siliconvalley4066/ESP32OLEDOscilloscope/README.md

# ESP32OLEDOscilloscope
ESP32 Oscilloscope for OLED and wireless WEB display

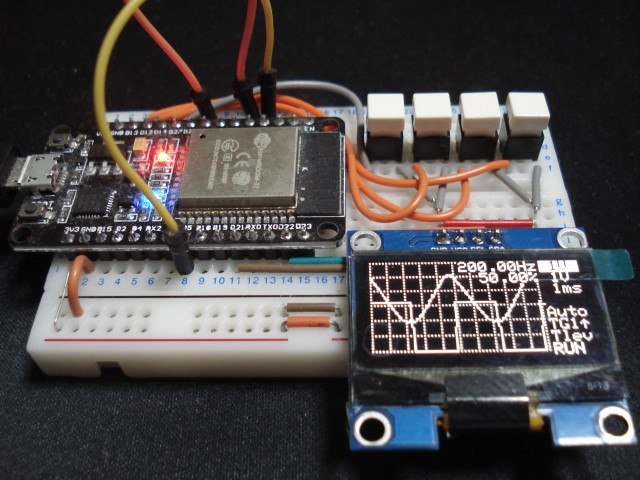
[picture p1: DSC00021.jpg]

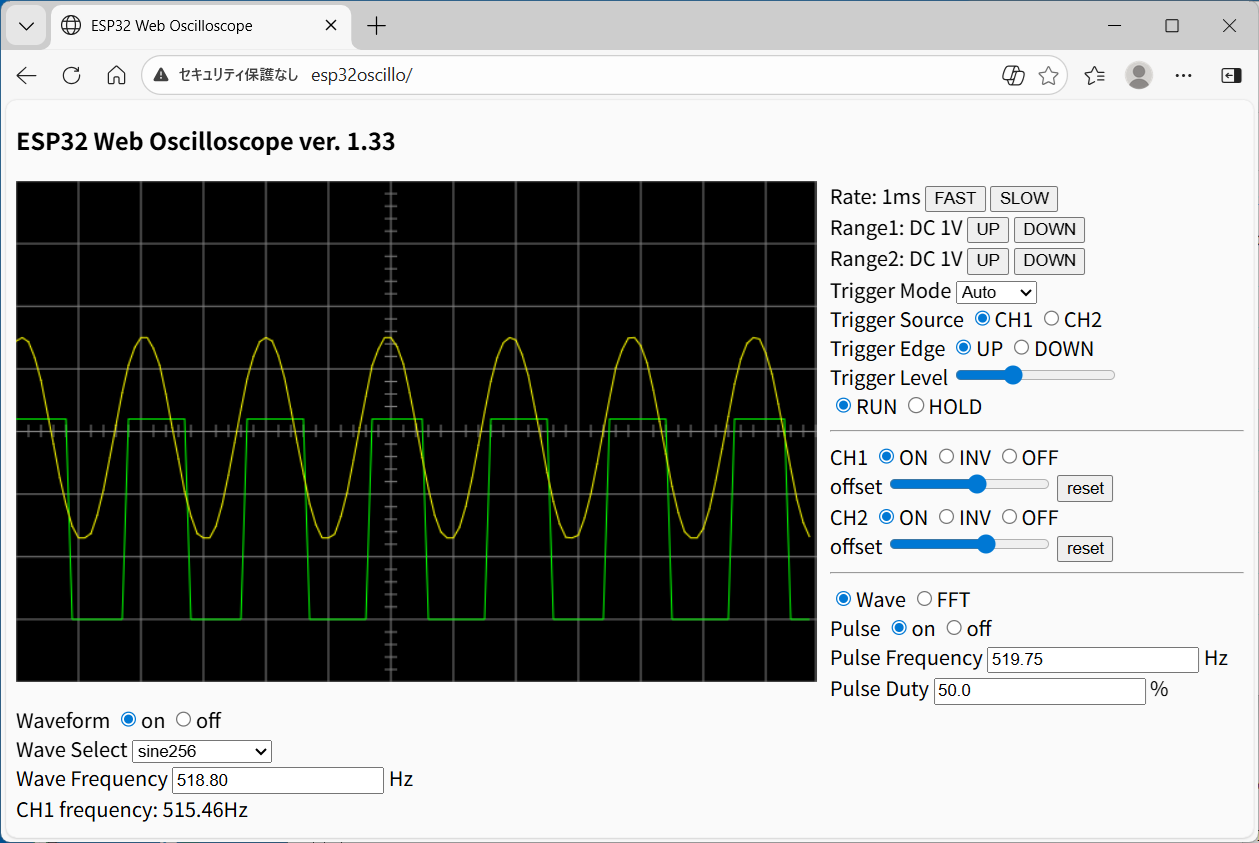
[picture p2: ESP32WEBOLED.png]


This displays an oscilloscope screen both on a 128x64 OLED and also on the WEB page simultaneusly.
The settings are controled by four tactile switches and also on the WEB page.
You can view the oscilloscope screen on the WEB browser of the PC or the tablet or the smartphone.

Specifications:
- Dual input channel
- Input voltage range 0 to 3.3V
- 12 bit ADC 250 ksps single channel, 100 ksps dual channel<br>
On ESP32-C3 Super Mini, 83.333 ksps single channel, 40 ksps dual channel
- Measures minimum, maximum and average values
- Measures frequency and duty cycle
- Spectrum FFT analysis
- Sampling rate selection
- Built in Pulse Generator
- Built in DDS Function Generator
- Built in Frequency Counter 1Hz - 32MHz (Max 40MHz)

<p>
Develop environment is:<br>
Arduino IDE 2.3.10<br>
esp32 by Espressif Systems version 3.3.12<br>
CPU speed 240 MHz<br>
  
Select the board for ESP32-C3 Super Mini: "Nologo ESP32C3 Super Mini"<br>
USB CDC On Boot: "Enabled"
</p>

Libraries:<br>
Adafruit_SSD1306<br>
Adafruit_SH110X<br>
arduinoFFT by Enrique Condes 2.0.0<br>
WebSockets by Markus Sattler version 2.7.2<br>
WiFiManager by tzapu 2.0.17<br>

4usec/div range is 10 times magnification at 250ksps.<br>
8usec/div range is 5 times magnification at 250ksps.<br>
20usec/div range is 2 times magnification at 250ksps.<br>
The magnification applies sin(x)/x interpolation.

WiFi Manager is used for web-based configuration.
For the initial setup only, connect to the access point named "ESP32_XXXXXXXX" (where "XXXXXXXX" is a unique chip ID) and navigate to "192.168.4.1".
From there, enter the SSID and password for your target WiFi network.
Once configured, no further setup is required.
If you wish to change these settings, hold down the "DOWN" button while the device is starting up.

Schematics:<br>
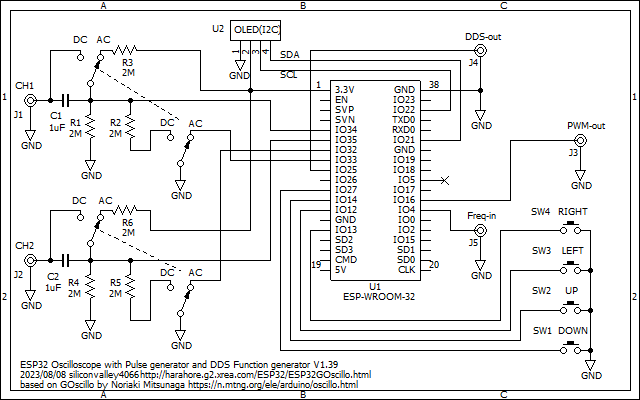
[picture p3: ESP32GOscillo2.png]


Schematics for ESP32-C3 Super Mini:<br>
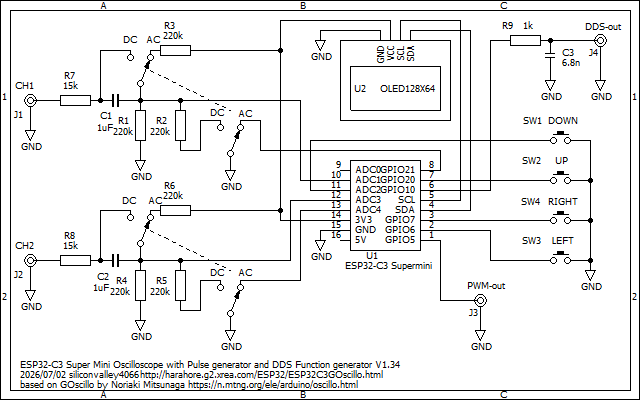
[picture p4: ESP32C3GOscillo.png]


Description is here, although it is written in Japanese language:<br>
https://ss1.xrea.com/harahore.g2.xrea.com/ESP32/ESP32WebOscillo.html
