siliconvalley4066/ESP32OLEDOscilloscope/(threads)

Thread 1 (2025-02-19):

Problem with Arduino ESP32 Nano board

rprior04938, 2025-02-19:
I'm trying to create your wonderful OLED Web multifunction oscilloscope using the Arduino IDE and an Arduino ESP32 nano board bought from Amazon which uses the ESP32S3 chip.  I followed your ReadMe instructions, loaded the necessary libraries, and have loaded the Arduino ESP32 Board manager Version 2.0.11 and the esp32 Version 2.0.11 manager.  The project won't compile.  In particular, the DAC functions seem to be missing.  I have found that the ESP idf  versions 4.x do contain them, and have read that the Arduino ESP32 Board manager version 2.0.11 roughly uses the ESP idf version 4.x libraries.  Do you have any thoughts about how to include those libraries in the Arduino ide?  Many thanks.  Rod

rprior04938, 2025-02-20:
I'v;e answered my own question.  The esp32 S3 doesn't contain any DAC's!.  Yellobyte has created an Arduino library DacESP32 to get around the problem, but it looks like the Oscilloscope sketch will need to be edited in order to use the Library.  Rod

Closed 2025-02-20.

Thread 2 (2025-03-09):

Compile Time Error, "timerAlarmEnable' was not declared in this scope"

ForrestErickson, 2025-03-09:
# Summary
Compile time error.

```
exit status 1

Compilation error: 'timerAlarmEnable' was not declared in this scope; did you mean 'timerAlarm'?
```

## Setup to reproduce
I forked the project.
I cloned the for locally.
I opened in Arduino IED 2.3.3 (See screen shot below)
I set device for for **ESP32 Dev Module**
I added the required libraries(s)
I compiled and got error(s)

**Screen shot:**
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

### Sample of Compiler Record With First Error

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

ForrestErickson, 2025-03-09:
# Same problem IDE 1.8.19
I tried the older IDE and reproduced the problem
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

ForrestErickson, 2025-03-09:
# Comment out timerAlarmEnable, Found Error on call of timerBegin
I commented out the two instances of call to timerAlarmEnable.
Found additional compile error.

```
exit status 1
too many arguments to function 'hw_timer_t* timerBegin(uint32_t)'

```

## Some Details of Error
DDS_DAC:118:23: error: too many arguments to function 'void timerAttachInterrupt(hw_timer_t*, void (*)())'
  118 |   timerAttachInterrupt(timer, &onTimer, true);
      |   ~~~~~~~~~~~~~~~~~~~~^~~~~~~~~~~~~~~~~~~~~~~

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

siliconvalley4066, 2025-04-20:
Use esp32 by Espressif Systems version 2.0.17
Version 3.0 and later does NOT support backward compatibility.

ForrestErickson, 2025-04-21:
Thanks for explaining.
I am not sure what "Use esp32 by Espressif Systems version 2.0.17" means.  Is this an Arduino IDE Library?

siliconvalley4066, 2025-04-22:
It is NOT an Arduino IDE Library.  It is a board support package.  You are using version 3.0.7.  You can version down it with Board Manager.
There are some problems with fast A/D conversion in version 3.0.7 that I can't fix.
