siliconvalley4066/ESP32OLEDOscilloscope/GOscillo/GOscillo.ino

/*
 * ESP32 Oscilloscope using a 128x64 OLED Version 1.43
 * for esp32 by Espressif Systems version 3.3.11
 * The max software loop sampling rates are 5ksps with 2 channels.
 * In the Continuous DMA mode, it can be set up to 100ksps with 2 channels and 250ksps with single channel.
 * + Pulse Generator
 * + PWM DDS Function Generator (23 waveforms)
 * + Frequency Counter
 * Copyright (c) 2023,2026, Siliconvalley4066
 */
/*
 * Arduino Oscilloscope using a graphic LCD
 * The max sampling rates are 4.3ksps with 2 channels and 8.6ksps with a channel.
 * Copyright (c) 2009, Noriaki Mitsunaga
 */

#include "driver/adc.h"
//#include "esp_task_wdt.h"

#if defined(ARDUINO_NOLOGO_ESP32C3_SUPER_MINI) || defined(ARDUINO_ESP32C3_DEV) || defined(ARDUINO_WAVESHARE_ESP32_C3_ZERO)
#define ESP32_C3
#endif
#ifndef ESP32_C3
#include "FreqCountESPgate.h"
#endif
//#define NOWEB
//#define BUTTON5DIR
#define DISPLAY_IS_SSD1306
//#define DISPLAY_IS_SH1107V
#define SCREEN_WIDTH   128              // OLED display width
#define SCREEN_HEIGHT   64              // OLED display height
#define OLED_RESET      -1      // Reset pin # (or -1 if sharing Arduino reset pin)
#ifdef DISPLAY_IS_SSD1306
#include <Adafruit_SSD1306.h>
Adafruit_SSD1306 display(SCREEN_WIDTH, SCREEN_HEIGHT, &Wire, OLED_RESET);
#else
#include <Adafruit_SH110X.h>
#ifdef DISPLAY_IS_SH1107V
Adafruit_SH1107 display = Adafruit_SH1107(SCREEN_HEIGHT, SCREEN_WIDTH, &Wire, OLED_RESET);
#else
Adafruit_SH1106G display = Adafruit_SH1106G(SCREEN_WIDTH, SCREEN_HEIGHT, &Wire, OLED_RESET);
#endif
#define WHITE 1
#define BLACK 0
#endif
#define EEPROM_START 0
#ifdef EEPROM_START
#include <EEPROM.h>
#endif
#include "arduinoFFT.h"
#define FFT_N 128
double vReal[FFT_N]; // Real part array, actually float type
double vImag[FFT_N]; // Imaginary part array
ArduinoFFT<double> FFT = ArduinoFFT<double>(vReal, vImag, FFT_N, 1.0);  // Create FFT object

#define txtLINE0   0
#define txtLINE1   8
#define txtLINE2   16
#define txtLINE3   24
#define txtLINE4   32
#define txtLINE5   40
#define txtLINE6   48
#define txtLINE7   56
#define DISPTXT 103

float waveFreq[2];             // frequency (Hz)
float waveDuty[2];             // duty ratio (%)
int dataMin[2];                // buffer minimum value (smallest=0)
int dataMax[2];                //        maximum value (largest=4095)
int dataAve[2];                // 10 x average value (use 10x value to keep accuracy. so, max=40950)
int saveTimer;                 // remaining time for saving EEPROM
int timeExec;                  // approx. execution time of current range setting (ms)
extern byte duty;
extern byte p_range;
extern unsigned short count;
extern long ifreq;
extern byte wave_id;

#define LCD_WIDTH 128
#define LCD_HEIGHT 64
const int LCD_YMAX = 60;
const int SAMPLES = 128;
const int NSAMP = 512;
const int DISPLNG = 100;
const int DOTS_DIV = 10;
const int TRIG_MAX = 80;
#ifdef ESP32_C3
const int ad_ch0 = ADC1_CHANNEL_1;  // Analog pin for channel 0
const int ad_ch1 = ADC1_CHANNEL_3;  // Analog pin for channel 1
#else
const int ad_ch0 = ADC1_CHANNEL_6;  // Analog 34 pin for channel 0
const int ad_ch1 = ADC1_CHANNEL_7;  // Analog 35 pin for channel 1
#endif
const long VREF[] = {33, 66, 165, 330, 660}; // reference voltage 3.3V ->  33 :   1V/div range (100mV/dot)
                                        //                        ->  66 : 0.5V/div
                                        //                        -> 165 : 0.2V/div
                                        //                        -> 330 : 100mV/div
                                        //                        -> 660 :  50mV/div
                                        // 3.3V / attn * DOTS_DIV / vdiv
//const int MILLIVOL_per_dot[] = {100, 50, 20, 10, 5}; // mV/dot
//const int ac_offset[] PROGMEM = {1676, -186, -1303, -1676, -1862};  // 3 div offset
//                              = 3 * vdiv / 3.3 * 4096 - 2048
const int ac_offset[] PROGMEM = {2917, 434, -1055, -1552, -1800}; // 4 div offset
//                              = 4 * vdiv / 3.3 * 4096 - 2048
const int MODE_ON = 0;
const int MODE_INV = 1;
const int MODE_OFF = 2;
const int MODE_NUL = 3;
const char Modes[3][4] PROGMEM = {" ON", "INV", "OFF"};
const int TRIG_AUTO = 0;
const int TRIG_NORM = 1;
const int TRIG_SCAN = 2;
const int TRIG_ONE  = 3;
const char TRIG_Modes[4][5] PROGMEM = {"Auto", "Norm", "Scan", "One "};
const int TRIG_E_UP = 0;
const int TRIG_E_DN = 1;
#define RATE_MIN 0
#define RATE_MAX 19
#define RATE_NUM 20
#ifndef ESP32_C3
#define RATE_DMA 7
#define RATE_DUAL 4
#else
#define RATE_DMA 7
#define RATE_DUAL 5
#endif
#define RATE_SLOW 9
#define RATE_ROLL 15
#define RATE_MAG 2
#ifndef ESP32_C3
#define ITEM_MAX 30
const char Rates[RATE_NUM][5] PROGMEM = {" 4us", " 8us", "20us", "40us", "100u", "200u", "500u", " 1ms", " 2ms", " 5ms", "10ms", "20ms", "50ms", "0.1s", "0.2s", "0.5s", " 1s ", " 2s ", " 5s ", " 10s"};
const unsigned long HREF[] PROGMEM = {40, 40, 40, 40, 100, 200, 500, 1000, 2000, 5000, 10000, 20000, 50000, 100000, 200000, 500000, 1000000, 2000000, 5000000, 10000000};
#else
#define ITEM_MAX 29
const char Rates[RATE_NUM][5] PROGMEM = {"12us", "24us", "60us", "120u", "200u", "250u", "500u", " 1ms", " 2ms", " 5ms", "10ms", "20ms", "50ms", "0.1s", "0.2s", "0.5s", " 1s ", " 2s ", " 5s ", " 10s"};
const unsigned long HREF[] PROGMEM = {120, 120, 120, 120, 200, 250, 500, 1000, 2000, 5000, 10000, 20000, 50000, 100000, 200000, 500000, 1000000, 2000000, 5000000, 10000000};
#endif
#define RANGE_MIN 0
#define RANGE_MAX 4
#define VRF 3.3
const char Ranges[5][5] PROGMEM = {" 1V ", "0.5V", "0.2V", "0.1V", "50mV"};
byte range0 = RANGE_MIN;
byte range1 = RANGE_MIN;
byte ch0_mode = MODE_ON, ch1_mode = MODE_ON, rate = 0, orate, wrate = 0;
byte wch0_mode = MODE_NUL, wch1_mode = MODE_NUL;
byte trig_mode = TRIG_AUTO, trig_lv = 10, trig_edge = TRIG_E_UP, trig_ch = ad_ch0;
bool Start = true;  // Start sampling
byte item = 0;      // Default item
byte menu = 0;      // Default menu
short ch0_off = 0, ch1_off = 400;
byte data[2][SAMPLES];                  // keep the number of channels buffer
uint32_t dma_buf[NSAMP*2], dma_buf1[NSAMP/2];
uint16_t *cap_buf = (uint16_t *)dma_buf, *cap_buf1 = (uint16_t *)dma_buf1;
#ifndef NOWEB
uint16_t payload[SAMPLES*2+2];
#endif
byte odat00, odat01, odat10, odat11;    // old data buffer for erase
byte sample=0;                          // index for double buffer
bool fft_mode = false, pulse_mode = false, dds_mode = false, fcount_mode = false;
bool full_screen = false;
byte info_mode = 3; // Text information display mode
bool dac_cw_mode = false;
int trigger_ad;
volatile bool wfft, wdds;
byte time_mag = 1;  // magnify timebase: 1, 2, 5 or 10
double compensation = 1.0;  // compensation for frequency counter
#ifndef ESP32_C3
boolean calib = false;      // calibrate flag for frequency counter
#endif
int trigger_pos;
int mag_pos = 0;

#ifdef ESP32_C3
#define ADC0PIN   1   // Analog pin for channel 0
#define ADC1PIN   3   // Analog pin for channel 1
#define LEFTPIN   6   // LEFT
#define RIGHTPIN  7   // RIGHT
#define UPPIN     20  // UP
#define DOWNPIN   2   // DOWN
#define CH0DCSW   21  // DC/AC switch ch0
#define CH1DCSW   4   // DC/AC switch ch1
//#define I2CSDA    8   // I2C SDA
//#define I2CSCL    9   // I2C SCL
#else
#define ADC0PIN   34  // Analog pin for channel 0
#define ADC1PIN   35  // Analog pin for channel 1
#define LEFTPIN   12  // LEFT
#define RIGHTPIN  13  // RIGHT
#define UPPIN     14  // UP
#define DOWNPIN   27  // DOWN
#define CH0DCSW   33  // DC/AC switch ch0
#define CH1DCSW   32  // DC/AC switch ch1
//#define I2CSDA    21  // I2C SDA
//#define I2CSCL    22  // I2C SCL
#endif
// DAC_CHANNEL_1  is GPIO25
// DAC_CHANNEL_2  is GPIO26
// ADC1_CHANNEL_0 is GPIO36
// ADC1_CHANNEL_1 is GPIO37
// ADC1_CHANNEL_2 is GPIO38
// ADC1_CHANNEL_3 is GPIO39
// ADC1_CHANNEL_4 is GPIO32
// ADC1_CHANNEL_5 is GPIO33
// ADC1_CHANNEL_6 is GPIO34
// ADC1_CHANNEL_7 is GPIO35
#define BGCOLOR   BLACK
#define GRIDCOLOR WHITE
#define CH1COLOR  WHITE
#define CH2COLOR  WHITE
#define TXTCOLOR  WHITE
#define TRGCOLOR  WHITE
#define HIGHCOLOR WHITE
#define LED_ON    HIGH
#define LED_OFF   LOW

TaskHandle_t taskHandle;

void setup(){
#ifndef NOWEB
  xTaskCreatePinnedToCore(setup1, "WebProcess", 4096, NULL, 4, &taskHandle, PRO_CPU_NUM); //Core 0でタスク開始
#endif
  pinMode(ADC0PIN, ANALOG);         // Analog pin for channel 0
  pinMode(ADC1PIN, ANALOG);         // Analog pin for channel 1
  pinMode(CH0DCSW, INPUT_PULLUP);   // CH1 DC/AC
  pinMode(CH1DCSW, INPUT_PULLUP);   // CH2 DC/AC
  pinMode(UPPIN, INPUT_PULLUP);     // up
  pinMode(DOWNPIN, INPUT_PULLUP);   // down
  pinMode(RIGHTPIN, INPUT_PULLUP);  // right
  pinMode(LEFTPIN, INPUT_PULLUP);   // left
#ifndef ESP32_C3
  pinMode(LED_BUILTIN, OUTPUT);     // sets the digital pin as output
#endif
#ifdef DISPLAY_IS_SSD1306
  display.begin(SSD1306_SWITCHCAPVCC, 0x3C);  // select 3C or 3D (set your OLED I2C address)
#else
  display.begin(0x3c, true);                  // initialise the library
#ifdef DISPLAY_IS_SH1107V
  display.setRotation(1);
#endif
#endif
  Wire.setClock(400000);
  delay(10);

//  Serial.begin(115200);
//  Serial.printf("CORE1 = %d\n", xPortGetCoreID());
#ifdef EEPROM_START
  EEPROM.begin(64);                     // set EEPROM size. Necessary for ESP32
  loadEEPROM();                         // read last settings from EEPROM
#else
  set_default();
#endif
//  set_default();
  menu = item >> 3;
  wfft = fft_mode;
  wdds = dds_mode;
  display.clearDisplay();
//  DrawGrid();
//  DrawText();
//  display.display();
#ifdef ESP32_C3
  adc1_config_channel_atten(ADC1_CHANNEL_1, ADC_ATTEN_DB_12);
  adc1_config_channel_atten(ADC1_CHANNEL_3, ADC_ATTEN_DB_12);
#else
  adc1_config_channel_atten(ADC1_CHANNEL_6, ADC_ATTEN_DB_11);
  adc1_config_channel_atten(ADC1_CHANNEL_7, ADC_ATTEN_DB_11);
#endif
  adc1_config_width(ADC_WIDTH_BIT_12);
  if (pulse_mode)
    pulse_init();                       // calibration pulse output
  if (dds_mode)
    dds_setup_init();
  orate = RATE_DMA + 1;                 // old rate befor change
  rate_dma_mode_config();
}

#ifndef NOLCD
void DrawGrid() {
  int disp_leng;
  if (full_screen) disp_leng = SAMPLES;
  else disp_leng = DISPLNG;
  for (int x=0; x<=disp_leng; x += 2) { // Horizontal Line
    for (int y=LCD_YMAX; y>=0; y -= DOTS_DIV) {
      display.drawPixel(x, y, GRIDCOLOR);
    }
  }
  CheckSW();
  for (int x=0; x<=disp_leng; x += DOTS_DIV ) { // Vertical Line
    for (int y=LCD_YMAX; y>=0; y -= 2) {
      display.drawPixel(x, y, GRIDCOLOR);
    }
  }
  CheckSW();
}

#ifndef ESP32_C3
void fcount_disp() {
  static unsigned long fcount = 0;

  if (!fcount_mode) return;
  if (FreqCount.available()) {
    fcount = FreqCount.read();
    if (calib) calibrate(fcount);
    calib = false;
    fcount = fcount * compensation;
  }
  displayfreq(fcount);
}

void displayfreq(unsigned long freq) {
  display.setTextColor(TXTCOLOR, BGCOLOR);
  String ss = String(freq);
  int l = ss.length();
  int n = l;
  if (l > 3) ++n;
  if (l > 6) ++n;
  display.setCursor(DISPLNG - 18 - 6 * n, txtLINE6);
  for (int i = 0; i < l; ++i) {
    display.print(ss[i]);
    if ((l-i) == 7) display.print(',');
    if ((l-i) == 4) display.print(',');
  }
  display.print("Hz");
}

void calibrate(unsigned long freq) {
  float references[] = {30e6, 25e6, 24e6, 20e6, 16e6, 12e6, 10e6, 8e6, 6e6, 5e6,
          4e6, 3e6, 2e6, 1e6, 1e5, 32768.0};
  int num = sizeof(references) / sizeof(float);
  for (int i = 0; i < num; ++i) {
    double ref = (double) references[i];
    if ((ref * 0.99995) < freq && freq < (ref * 1.00005)) { // 50ppm
      compensation = ref / (double) freq;
      break;
    }
  }
}
#endif

void display_range(byte rng) {
  display.print(Ranges[rng]);
}

void display_rate(void) {
  display.print(Rates[rate]);
}

void display_mode(byte chmode) {
  display.print(Modes[chmode]); 
}

void display_trig_mode(void) {
  display.print(TRIG_Modes[trig_mode]); 
}

void display_ac(byte pin) {
  if (digitalRead(pin) == LOW) display.print('~');
}

void set_line_color(byte line) {
  if ((item & 0x7) == line) display.setTextColor(BGCOLOR, TXTCOLOR);  // highlight
  else display.setTextColor(TXTCOLOR, BGCOLOR);           // normal
#if LCD_HEIGHT == 64
  display.setCursor(DISPTXT, 8 * line); // locate curser for printing text
#elif LCD_HEIGHT == 80
  display.setCursor(DISPTXT, 10 * line + 1); // locate curser for printing text
#endif
}

void DrawGrid(int x) {
  if ((x % DOTS_DIV) == 0) {
    for (int y=LCD_YMAX; y>=0; y -= 2)
      display.drawPixel(x, y, GRIDCOLOR);
  } else if ((x % 2) == 0)
    for (int y=LCD_YMAX; y>=0; y -= DOTS_DIV)
      display.drawPixel(x, y, GRIDCOLOR);
}

void ClearAndDrawGraph() {
  int disp_leng;
  if (full_screen) disp_leng = SAMPLES-1;
  else disp_leng = DISPLNG-1;
  bool ch1_active = ch1_mode != MODE_OFF && !(rate < RATE_DUAL && ch0_mode != MODE_OFF);
#if 0
  for (int x=0; x<disp_leng; x++) {
    display.drawPixel(x, LCD_YMAX-data[sample+0][x], CH1COLOR);
    display.drawPixel(x, LCD_YMAX-data[sample+1][x], CH2COLOR);
  }
#else
  for (int x=0; x<disp_leng; x++) {
    if (ch0_mode != MODE_OFF) {
      display.drawLine(x, LCD_YMAX-data[sample+0][x], x+1, LCD_YMAX-data[sample+0][x+1], CH1COLOR);
    }
    if (ch1_active) {
      display.drawLine(x, LCD_YMAX-data[sample+1][x], x+1, LCD_YMAX-data[sample+1][x+1], CH2COLOR);
    }
  }
#endif
}

void ClearAndDrawDot(int i) {
  DrawGrid(i);
#if 0
  for (int x=0; x<DISPLNG; x++) {
    display.drawPixel(i, LCD_YMAX-odat01, BGCOLOR);
    display.drawPixel(i, LCD_YMAX-odat11, BGCOLOR);
    display.drawPixel(i, LCD_YMAX-data[sample+0][i], CH1COLOR);
    display.drawPixel(i, LCD_YMAX-data[sample+1][i], CH2COLOR);
  }
#else
  if (i < 1) {
    return;
  }
  if (ch0_mode != MODE_OFF) {
    display.drawLine(i-1, LCD_YMAX-odat00,   i, LCD_YMAX-odat01, BGCOLOR);
    display.drawLine(i-1, LCD_YMAX-data[0][i-1], i, LCD_YMAX-data[0][i], CH1COLOR);
  }
  if (ch1_mode != MODE_OFF) {
    display.drawLine(i-1, LCD_YMAX-odat10,   i, LCD_YMAX-odat11, BGCOLOR);
    display.drawLine(i-1, LCD_YMAX-data[1][i-1], i, LCD_YMAX-data[1][i], CH2COLOR);
  }
#endif
}
#endif

#ifdef ESP32_C3
#define BENDX 3150  // 76% of 4096
#define BENDY 3072  // 75% of 4096
#else
#define BENDX 3480  // 85% of 4096
#define BENDY 3072  // 75% of 4096
#endif

int16_t adc_linearlize(int16_t level) {
  if (level < BENDY) {
    level = map(level, 0, BENDY, 0, BENDX);
  } else {
    level = map(level, BENDY, 4095, BENDX, 4095);
  }
  return level;
}

void scaleDataArray(byte ad_ch, int trig_point)
{
  byte *pdata, ch_mode, range, ch;
  short ch_off;
  uint16_t *idata, *qdata, *rdata;
  long a, b;

  trigger_pos = trig_point;
  if (ad_ch == ad_ch1) {
    ch_off = ch1_off;
    ch_mode = ch1_mode;
    range = range1;
    idata = &cap_buf1[trig_point];
#ifndef NOWEB
    qdata = rdata = payload+SAMPLES;
#endif
    ch = 1;
  } else {
    ch_off = ch0_off;
    ch_mode = ch0_mode;
    range = range0;
    idata = &cap_buf[trig_point];
#ifndef NOWEB
    qdata = rdata = payload;
#endif
    ch = 0;
  }
  pdata = data[ch];
  for (int i = 0; i < SAMPLES; i++) {
    *idata = adc_linearlize(*idata);
    a = ((*idata + ch_off) * VREF[range] + 2048) >> 12;
    if (a > LCD_YMAX) a = LCD_YMAX;
    else if (a < 0) a = 0;
    if (ch_mode == MODE_INV)
      a = LCD_YMAX - a;
    *pdata++ = (byte) a;
#ifndef NOWEB
    b = ((*idata++ + ch_off) * VREF[range] + 40) / 80;
    if (b > 4095) b = 4095;
    else if (b < 0) b = 0;
    if (ch_mode == MODE_INV)
      b = 4095 - b;
    *qdata++ = (int16_t) b;
#else
    ++idata;
#endif
  }
  int mag_mag = time_mag;
  if (rate == 0) {
    mag_mag = 10; mag_pos = 0;  // x10 magnification for display
  } else if (rate == 1) {
    mag_mag = 5; mag_pos = 0;   // x5 magnification for display
  } else if (rate == 2) {
    mag_mag = 2; mag_pos = 0;   // x2 magnification for display
  }
  if (rate < RATE_ROLL) {
    switch (mag_mag) {
    case 2:
    case 5:
    case 10:
      // Empirical: ensures mag() does not read beyond buffer end for factors 2/5/10
      mag_pos = constrain(mag_pos, 0, SAMPLES - SAMPLES/mag_mag - 6);
      mag(data[sample+ch], mag_mag, mag_pos);   // magnify timebase for display
#ifndef NOWEB
      mag(rdata, mag_mag, mag_pos);             // magnify timebase for WEB
#endif
      break;
    default:
      time_mag = 1;   // fix odd value
      mag_pos = 0;    // reset the position
      break;
    }
  }
}

byte adRead(byte ch, byte mode, int off, int i)
{
  int16_t aa = adc1_get_raw((adc1_channel_t) ch);  // ADC read and save approx 46us
  aa = adc_linearlize(aa);
  long a = (((long)aa+off)*VREF[ch == ad_ch0 ? range0 : range1]+2048) >> 12;
  if (a > LCD_YMAX) a = LCD_YMAX;
  else if (a < 0) a = 0;
  if (mode == MODE_INV)
    a = LCD_YMAX - a;
#ifndef NOWEB
  long b = (((long)aa+off)*VREF[ch == ad_ch0 ? range0 : range1] + 40) / 80;
  if (b > 4095) b = 4095;
  else if (b < 0) b = 0;
  if (mode == MODE_INV)
    b = 4095 - b;
#endif
  if (ch == ad_ch1) {
    cap_buf1[i] = aa;
#ifndef NOWEB
    payload[i+SAMPLES] = b;
#endif
  } else {
    cap_buf[i] = aa;
#ifndef NOWEB
    payload[i] = b;
#endif
  }
  return a;
}

int advalue(int value, long vref, byte mode, int offs) {
  if (mode == MODE_INV)
    value = LCD_YMAX - value;
  return ((long)value << 12) / vref - offs;
}

void set_trigger_ad() {
  if (trig_ch == ad_ch0) {
    trigger_ad = advalue(trig_lv, VREF[range0], ch0_mode, ch0_off);
  } else {
    trigger_ad = advalue(trig_lv, VREF[range1], ch1_mode, ch1_off);
  }
}

void loop() {
  int oad, ad;
  unsigned long auto_time;

  timeExec = 100;
  led_on();
  if (rate > RATE_DMA) {
    set_trigger_ad();
    auto_time = pow(10, rate / 3) + 5;
    if (trig_mode != TRIG_SCAN) {
      unsigned long st = millis();
      oad = adc1_get_raw((adc1_channel_t)trig_ch)&0xfffc;
      for (;;) {
        ad = adc1_get_raw((adc1_channel_t)trig_ch)&0xfffc;

        if (trig_edge == TRIG_E_UP) {
          if (ad > trigger_ad && trigger_ad > oad)
            break;
        } else {
          if (ad < trigger_ad && trigger_ad < oad)
            break;
        }
        oad = ad;

        if (rate > RATE_SLOW)
          CheckSW();      // no need for fast sampling
        if (trig_mode == TRIG_SCAN)
          break;
        if (trig_mode == TRIG_AUTO && (millis() - st) > auto_time)
          break; 
      }
    }
  }

  // sample and draw depending on the sampling rate
  if (rate < RATE_ROLL && Start) {

    if (rate <= RATE_DMA) { // channel 0 or 1 DMA sampling (Max 250ksps)
      sample_dma();
    } else if (rate == 6) { // channel 0 or 1 50us sampling
      sample_200us(50);
    } else if (rate >= 7 && rate <= 8) {  // dual channel 100us, 200us sampling
      sample_dual_us(HREF[rate] / 10);
    } else {                // dual channel .5ms, 1ms, 2ms, 5ms, 10ms, 20ms sampling
      sample_dual_ms(HREF[rate] / 10);
    }
    led_off();
    draw_screen();
  } else if (Start) { // 50ms - 1000ms sampling
    timeExec = 5000;
    static const unsigned long r_[] PROGMEM = {50000, 100000, 200000, 500000, 1000000};
    unsigned long r;
    int disp_leng;
    if (full_screen) disp_leng = SAMPLES;
    else disp_leng = DISPLNG;
//    unsigned long st0 = millis();
    unsigned long st = micros();
    for (int i=0; i<disp_leng; i ++) {
      if (!full_screen && i >= DISPLNG) break;
      r = r_[rate - RATE_ROLL];  // rate may be changed in loop
      while((st - micros())<r) {
        CheckSW();
        if (rate < RATE_ROLL)
          break;
      }
      if (rate<RATE_ROLL) { // sampling rate has been changed
#ifndef NOLCD
        display.clearDisplay();
#endif
        break;
      }
      st += r;
      if (st - micros()>r)
          st = micros(); // sampling rate has been changed to shorter interval
      if (!Start) {
         i --;
         continue;
      }
      odat00 = odat01;      // save next previous data ch0
      odat10 = odat11;      // save next previous data ch1
      odat01 = data[0][i];  // save previous data ch0
      odat11 = data[1][i];  // save previous data ch1
      if (ch0_mode != MODE_OFF) data[0][i] = adRead(ad_ch0, ch0_mode, ch0_off, i);
      if (ch1_mode != MODE_OFF) data[1][i] = adRead(ad_ch1, ch1_mode, ch1_off, i);
#ifndef NOWEB
      if (ch0_mode == MODE_OFF) payload[0] = -1;
      if (ch1_mode == MODE_OFF) payload[SAMPLES] = -1;
      xTaskNotify(taskHandle, 0, eNoAction);  // notify Websocket server task
#endif
#ifndef NOLCD
      ClearAndDrawDot(i);
      display.display();  // 42ms
#endif
    }
    // Serial.println(millis()-st0);
    led_off();
#ifndef NOLCD
    DrawGrid();
    if (!full_screen) DrawText();
  } else {
    DrawText();
#endif
  }
  if (trig_mode == TRIG_ONE)
    Start = false;
  CheckSW();
#ifdef EEPROM_START
  saveEEPROM();                         // save settings to EEPROM if necessary
#endif
  if (wdds != dds_mode) {
    if (wdds) {
      dds_setup();
    } else {
      dds_close();
    }
    dds_mode = wdds;
  }
}

void draw_screen() {
#ifndef NOLCD
  display.clearDisplay();
#endif
  if (wfft != fft_mode) {
    fft_mode = wfft;
  }
  if (fft_mode) {
#ifndef NOLCD
    DrawText();
#endif
    plotFFT();
  } else {
#ifndef NOLCD
    DrawGrid();
    ClearAndDrawGraph();
    CheckSW();
    if (!full_screen) DrawText();
    mag_bar();
#endif
#ifndef NOWEB
    if (ch0_mode == MODE_OFF) payload[0] = -1;
    if (ch1_mode == MODE_OFF) payload[SAMPLES] = -1;
#endif
  }
#ifndef NOWEB
  xTaskNotify(taskHandle, 0, eNoAction);  // notify Websocket server task
  vTaskDelay(10);    // wait Web task to send it (adhoc fix)
#endif
#ifndef NOLCD
  display.display();
#endif
}

#define textINFO (DISPLNG-48)
void measure_frequency(int ch) {
  int x1, x2;
  freqDuty(ch);
#ifndef NOLCD
  display.setCursor(textINFO, txtLINE0);
  float freq = waveFreq[ch];
  if (freq < 999.5)
    display.print(freq);
  else if (freq < 999999.5)
    display.print(freq, 0);
  else {
    display.print(freq/1000.0, 0);
    display.print('k');
  }
  display.print("Hz");
  if (fft_mode) return;
  display.setCursor(textINFO + 18, txtLINE1);
  float duty = waveDuty[ch];
  if (duty > 99.9499) duty = 99.9;
  display.print(duty, 1);  display.print('%');
#endif
}

void measure_voltage(int ch) {
  int x;
  if (fft_mode) return;
  float vavr = VRF * dataAve[ch] / 40950.0;
  float vmax = VRF * dataMax[ch] / 4095.0;
  float vmin = VRF * dataMin[ch] / 4095.0;
#ifndef NOLCD
  display.setCursor(textINFO, txtLINE2);
  display.print("max");  display.print(vmax); if (vmax >= 0.0) display.print('V');
  display.setCursor(textINFO, txtLINE3);
  display.print("avr");  display.print(vavr); if (vavr >= 0.0) display.print('V');
  display.setCursor(textINFO, txtLINE4);
  display.print("min");  display.print(vmin); if (vmin >= 0.0) display.print('V');
#endif
}

void sample_dual_us(unsigned int r) { // dual channel. r > 67
  if (ch0_mode != MODE_OFF && ch1_mode == MODE_OFF) {
    unsigned long st = micros();
    for (int i=0; i<SAMPLES; i ++) {
      while(micros() - st < r) ;
      cap_buf[i] = adc1_get_raw((adc1_channel_t) ad_ch0);
      st += r;
    }
    scaleDataArray(ad_ch0, 0);
    memset(data[1], 0, SAMPLES);
  } else if (ch0_mode == MODE_OFF && ch1_mode != MODE_OFF) {
    unsigned long st = micros();
    for (int i=0; i<SAMPLES; i ++) {
      while(micros() - st < r) ;
      cap_buf1[i] = adc1_get_raw((adc1_channel_t) ad_ch1);
      st += r;
    }
    scaleDataArray(ad_ch1, 0);
    memset(data[0], 0, SAMPLES);
  } else {
    unsigned long st = micros();
    for (int i=0; i<SAMPLES; i ++) {
      while(micros() - st < r) ;
      cap_buf[i] = adc1_get_raw((adc1_channel_t) ad_ch0);
      cap_buf1[i] = adc1_get_raw((adc1_channel_t) ad_ch1);
      st += r;
    }
    scaleDataArray(ad_ch0, 0);
    scaleDataArray(ad_ch1, 0);
  }
}

void sample_dual_ms(unsigned int r) { // dual channel. r > 500
// .5ms, 1ms or 2ms sampling
  unsigned long st = micros();
  for (int i=0; i<SAMPLES; i ++) {
    while(micros() - st < r) ;
    st += r;
    if (ch0_mode != MODE_OFF) {
      cap_buf[i] = adc1_get_raw((adc1_channel_t) ad_ch0);
    }
    if (ch1_mode != MODE_OFF) {
      cap_buf1[i] = adc1_get_raw((adc1_channel_t) ad_ch1);
    }
  }
//  if (ch0_mode == MODE_OFF) memset(data[0], 0, SAMPLES);
//  if (ch1_mode == MODE_OFF) memset(data[1], 0, SAMPLES);
  scaleDataArray(ad_ch0, 0);
  scaleDataArray(ad_ch1, 0);
}

// adc1_get_raw() with timing, channel 0 or 1. 500us/div 20ksps
void sample_200us(unsigned int r) {
  uint16_t *idata;
  int ad_ch;
  if (ch0_mode == MODE_OFF && ch1_mode != MODE_OFF) {
    ad_ch = ad_ch1;
    idata = cap_buf1;
  } else {
    ad_ch = ad_ch0;
    idata = cap_buf;
  }
  unsigned long st = micros();
//  disableCore1WDT();
  for (int i=0; i<SAMPLES; i ++) {
    while(micros() - st < r) ;
    *idata++ = adc1_get_raw((adc1_channel_t) ad_ch);
    st += r;
//    yield();
//    esp_task_wdt_reset();
  }
//  enableCore1WDT();
  vTaskDelay(1);
  scaleDataArray(ad_ch, 0);
  vTaskDelay(1);
}

void plotFFT() {
  int ylim = LCD_HEIGHT - 8;

  int j = 0;
  if (rate <= RATE_DMA) {
    j = trigger_pos;
  }
  for (int i = 0; i < FFT_N; i++) {
    vReal[i] = cap_buf[j++];
    vImag[i] = 0.0;
  }
  FFT.dcRemoval();
  FFT.windowing(FFTWindow::Hann, FFTDirection::Forward);  // Weigh data
  FFT.compute(FFTDirection::Forward);                     // Compute FFT
  FFT.complexToMagnitude();                               // Compute magnitudes
#ifndef NOWEB
  payload[0] = 0;
#endif
  for (int i = 1; i < FFT_N/2; i++) {
    float db = log10(vReal[i]);
#ifndef NOWEB
    payload[i] = constrain((int)(1024.0 * (db - 1.6)), 0, 4095);
#endif
#ifndef NOLCD
    int dat = constrain((int)(15.0 * db - 20), 0, ylim);
    display.drawFastVLine(i * 2, ylim - dat, dat, CH1COLOR);
#endif
  }
  draw_scale();
}

void draw_scale() {
  int ylim = LCD_HEIGHT - 8;
  float fhref, nyquist;
#ifndef NOLCD
  display.setTextColor(TXTCOLOR);
  display.setCursor(0, ylim); display.print("0Hz"); 
#endif
  fhref = freqhref();
  nyquist = 5.0e6 / fhref; // Nyquist frequency
#ifndef NOWEB
  long inyquist = nyquist;
  payload[FFT_N/2] = (short) (inyquist / 1000);
  payload[FFT_N/2+1] = (short) (inyquist % 1000);
#endif
#ifndef NOLCD
  if (nyquist > 999.0) {
    nyquist = nyquist / 1000.0;
    if (nyquist > 99.5) {
      display.setCursor(58, ylim); display.print(nyquist/2,0);display.print('k');
      display.setCursor(104, ylim); display.print(nyquist,0);
    } else if (nyquist > 9.95) {
      display.setCursor(58, ylim); display.print(nyquist/2,0);display.print('k');
      display.setCursor(110, ylim); display.print(nyquist,0);
    } else {
      display.setCursor(52, ylim); display.print(nyquist/2,1);display.print('k');
      display.setCursor(104, ylim); display.print(nyquist,1);
    }
    display.print('k');
  } else {
    display.setCursor(58, ylim); display.print(nyquist/2,0);
    display.setCursor(110, ylim); display.print(nyquist,0);
  }
#endif
}

float freqhref() {
  return (float) HREF[rate];
}

#if defined(ESP32_C3) && !defined(NOLCD)
void led_on(void) {}

void led_off(void) {}
#else
void led_on(void) {
  digitalWrite(LED_BUILTIN, LED_ON);
}

void led_off(void) {
  digitalWrite(LED_BUILTIN, LED_OFF);
}
#endif

#ifdef EEPROM_START
void saveEEPROM() {                   // Save the setting value in EEPROM after waiting a while after the button operation.
  uint16_t p = EEPROM_START;
  if (saveTimer > 0) {                // If the timer value is positive
    saveTimer = saveTimer - timeExec; // Timer subtraction
    if (saveTimer <= 0) {             // if time up
      EEPROM.write(p++, range0);      // save current status to EEPROM
      EEPROM.write(p++, ch0_mode);
      EEPROM.write(p++, lowByte(ch0_off));  // save as Little endian
      EEPROM.write(p++, highByte(ch0_off));
      EEPROM.write(p++, range1);
      EEPROM.write(p++, ch1_mode);
      EEPROM.write(p++, lowByte(ch1_off));  // save as Little endian
      EEPROM.write(p++, highByte(ch1_off));
      EEPROM.write(p++, rate);
      EEPROM.write(p++, trig_mode);
      EEPROM.write(p++, trig_lv);
      EEPROM.write(p++, trig_edge);
      EEPROM.write(p++, trig_ch);
      EEPROM.write(p++, fft_mode);
      EEPROM.write(p++, info_mode);
      EEPROM.write(p++, item);
      EEPROM.write(p++, pulse_mode);
      EEPROM.write(p++, duty);
      EEPROM.write(p++, p_range);
      EEPROM.write(p++, lowByte(count));  // save as Little endian
      EEPROM.write(p++, highByte(count));
      EEPROM.write(p++, dds_mode);
      EEPROM.write(p++, wave_id);
      EEPROM.write(p++, ifreq & 0xff);
      EEPROM.write(p++, (ifreq >> 8) & 0xff);
      EEPROM.write(p++, (ifreq >> 16) & 0xff);
      EEPROM.write(p++, (ifreq >> 24) & 0xff);
      EEPROM.write(p++, dac_cw_mode);
      EEPROM.write(p++, time_mag);
      byte *q = (byte *) &compensation;
      for (int i = 0; i < 8; ++i)
        EEPROM.write(p++, *q++);
      EEPROM.commit();    // actually write EEPROM. Necessary for ESP32
    }
  }
}
#endif

void set_default() {
  range0 = RANGE_MIN;
  ch0_mode = MODE_ON;
  ch0_off = 0;
  range1 = RANGE_MIN;
  ch1_mode = MODE_ON;
  ch1_off = 2048;
  rate = 6;
  trig_mode = TRIG_AUTO;
  trig_lv = 20;
  trig_edge = TRIG_E_UP;
  trig_ch = ad_ch0;
  fft_mode = false;
  info_mode = 1;  // display frequency and duty.  Voltage display is off
  item = 0;       // menu item
  pulse_mode = true;
  duty = 128;     // PWM 50%
  p_range = 16;   // PWM range
  count = 256;    // PWM 1220Hz
  dds_mode = true;
  wave_id = 0;    // sine wave
  ifreq = 23841;  // 238.41Hz
  dac_cw_mode = false;
  time_mag = 1;   // magnify timebase
  compensation = 1.0; // frequency counter
}

extern const byte wave_num;

#ifdef EEPROM_START
void loadEEPROM() { // Read setting values from EEPROM (abnormal values will be corrected to default)
  uint16_t p = EEPROM_START, error = 0;

  range0 = EEPROM.read(p++);                // range0
  if ((range0 < RANGE_MIN) || (range0 > RANGE_MAX)) ++error;
  ch0_mode = EEPROM.read(p++);              // ch0_mode
  if (ch0_mode > 2) ++error;
  *((byte *)&ch0_off) = EEPROM.read(p++);     // ch0_off low
  *((byte *)&ch0_off + 1) = EEPROM.read(p++); // ch0_off high
  if ((ch0_off < -8192) || (ch0_off > 8191)) ++error;

  range1 = EEPROM.read(p++);                // range1
  if ((range1 < RANGE_MIN) || (range1 > RANGE_MAX)) ++error;
  ch1_mode = EEPROM.read(p++);              // ch1_mode
  if (ch1_mode > 2) ++error;
  *((byte *)&ch1_off) = EEPROM.read(p++);     // ch1_off low
  *((byte *)&ch1_off + 1) = EEPROM.read(p++); // ch1_off high
  if ((ch1_off < -8192) || (ch1_off > 8191)) ++error;

  rate = EEPROM.read(p++);                  // rate
  if ((rate < RATE_MIN) || (rate > RATE_MAX)) ++error;
//  if (ch0_mode == MODE_OFF && rate < 5) ++error;  // correct ch0_mode
  trig_mode = EEPROM.read(p++);             // trig_mode
  if (trig_mode > TRIG_SCAN) ++error;
  trig_lv = EEPROM.read(p++);               // trig_lv
  if (trig_lv > TRIG_MAX) ++error;
  trig_edge = EEPROM.read(p++);             // trig_edge
  if (trig_edge > 1) ++error;
  trig_ch = EEPROM.read(p++);               // trig_ch
  if (trig_ch != ad_ch0 && trig_ch != ad_ch1) ++error;
  fft_mode = EEPROM.read(p++);              // fft_mode
  info_mode = EEPROM.read(p++);             // info_mode
  if (info_mode > 7) ++error;
  item = EEPROM.read(p++);                  // item
  if (item > ITEM_MAX) ++error;
  pulse_mode = EEPROM.read(p++);            // pulse_mode
  duty = EEPROM.read(p++);                  // duty
  p_range = EEPROM.read(p++);               // p_range
  if (p_range > 16) ++error;
  *((byte *)&count) = EEPROM.read(p++);     // count low
  *((byte *)&count + 1) = EEPROM.read(p++); // count high
  if (count > 1023) ++error;
  dds_mode = EEPROM.read(p++);              // DDS mode
  wave_id = EEPROM.read(p++);               // DDS wave id
  if (wave_id >= wave_num) ++error;
  *((byte *)&ifreq) = EEPROM.read(p++);     // ifreq low
  *((byte *)&ifreq + 1) = EEPROM.read(p++); // ifreq
  *((byte *)&ifreq + 2) = EEPROM.read(p++); // ifreq
  *((byte *)&ifreq + 3) = EEPROM.read(p++); // ifreq high
  if (ifreq > 99999L) ++error;
  dac_cw_mode = EEPROM.read(p++);           // DDS CW mode
  time_mag = EEPROM.read(p++);              // magnify timebase
  byte *q = (byte *) &compensation;
  for (int i = 0; i < 8; ++i)
    *q++ = EEPROM.read(p++);
  if (compensation < 1.002 && compensation > 0.998) ; // OK
  else ++error;
  if (error > 0) {
    set_default();
  }
}
#endif
