siliconvalley4066/ESP32OLEDOscilloscope/(commit log)

2023-10-19 display frequency on WEB page
    display frequency on WEB page.
    ADC use I2S_CHANNEL_FMT_ONLY_LEFT
2024-03-12 magnify x2 x5 x10
    magnify x2 x5 x10
    arduinoFFT 2.0.0
2024-03-12 arduinoFFT 2.0.0
2025-09-03 Warning!!! Use old esp32 by Espressif Systems version 2.0.17
2026-01-13 esp32 version 3.3.5
    for esp32 by Espressif Systems version 3.3.5
2026-01-13 Revise ESP32 version details in README
    Updated ESP32 version information and removed outdated warning.
2026-07-02 support ESP32-C3
2026-08-02 ESP32-C3 ADC continuous mode
    up to 83.3ksps
2026-08-07 ESP32 ADC continuous mode
2026-08-07 ESP32-C3 Super Mini
2026-08-07 Revise ADC specifications and IDE version
    Updated specifications and development environment details.
2026-08-16 Update ESP32 version in README
2026-08-19 impliment FreqcCountESP
    migrate FreqcCountESP to ESP32 3.3.11
2026-08-19 fix frequency counter compensation
    [GOscillo.ino]
2026-10-01 update Frequency Counter and PWM
    update Frequency Counter
    update PWM Pulse Generator
